abdulmajeed90/hopemesh-thesis/thesis/presentation.tex

\documentclass{beamer}
\usetheme{Madrid}

\usepackage[english]{babel}
\usepackage[utf8]{inputenc}

\usepackage{tikz}
\usetikzlibrary{mindmap,trees}

\usepackage{import}

\usepackage{listings}
\lstset{basicstyle=\footnotesize\ttfamily}

\title[Master thesis presentation]{Communication algorithms and principles for a prototype of a wireless mesh network}
\author[Sergiusz Urbaniak]{}
\institute[WIZUT]
{
    Zachodniopomorski Uniwersytet Technologiczny w Szczecinie \\
    Wydział Informatyki \\[2cm]
    Sergiusz Urbaniak
}

\date[Szczecin, 2011]{}

\begin{document}
\include{slides}
\end{document}
