abdulmajeed90/hopemesh-thesis/thesis/praca.tex

% comment/uncomment for oneside production (odd and even pages have same margins)
\input{class}
%\documentclass[12pt, oneside]{_praca_dyplomowa}

% comment/uncomment for twoside production (odd and even pages have reverse margins)
% \documentclass[12pt, twoside]{_praca_dyplomowa}

% rozmiar marginesów
\usepackage[a4paper, left=3.5cm, right=2cm, bottom=2.5cm, top=3cm]{geometry}
% zmieniony margines dla stron parzystych (druk dwustronny):
%\usepackage[a4paper, left=2cm, right=3.5cm, bottom=2.5cm, top=3cm]{geometry}
%\usepackage{times}
%\usepackage[default, none]{oxford}
%\usepackage{chicago}
% polskie znaki
\usepackage{setspace}
\usepackage{amsmath}
%\usepackage{graphs}

\usepackage[english]{babel}
%\usepackage[OT4]{polski}
\usepackage[T1]{fontenc}
%\usepackage[MeX]{polski}
\usepackage[utf8]{inputenc}
\usepackage[parfill]{parskip}

%\usepackage[pausing]{tracefnt}

% rysunki w formacie EPS
\usepackage[pdftex]{color,graphicx}
\usepackage{graphicx}
\usepackage{epsfig}
\graphicspath{{figures/}}
\usepackage[pausing]{tracefnt}
%\usepackage{indentfirst} % akapit w pierwszej linii
\usepackage{color}
\definecolor{listing}{rgb}{0.1,0.3,0.3}
\usepackage{hyperref}
\hypersetup{
	unicode=true,
	pdftitle={Praca dyplomowa},
	pdfauthor={Sergiusz Urbaniak},
	pdfsubject={},
	pdfborder={0 0 0},
	pdfstartview=FitB,
	pdflang=pl,
	pdfdisplaydoctitle=true,
	plainpages=false
}
\usepackage{rotating}
\usepackage{import}
\usepackage{algorithmic}
\usepackage{algorithm}

\usepackage{listings}
\lstset{basicstyle=\footnotesize\ttfamily}

\usepackage{pdfpages}
\usepackage{url}

\usepackage{tikz}
\usetikzlibrary{mindmap,trees}

\usepackage{wrapfig}
\usepackage{lscape}

% uncomment next line in order to show margins in produced PDF
% \usepackage{showframe}

%\fontsize{10}{12pt}
\providecommand{\abs}[1]{\lvert#1\rvert}

%INFORMACJA O PRACY
%==================
\tytul{Communication algorithms and principles for a prototype of a wireless mesh network}
\engtitle{Communication algorithms and principles for a prototype of a wireless mesh network}
\autor{Sergiusz Urbaniak}
\opiekun{dr inż. Remigiusz Olejnik}
\rok{2011}
\slowa{rf12b, rfm12b, hoperf, avr, atmega16, topologia kratowa, sieæ}
\opis{Description}
\kwords{}
\describe{Description}
\sloppy

\begin{document}

%\renewcommand\tablename{Tabela}
%\renewcommand\figurename{Rys.}

\include{strona_tytulowa}
\setstretch{1.6}
\include{oswiadczenie}
\include{abstract}
\tableofcontents
\listoffigures
%\renewcommand\listtablename{Spis tabel} 
\listoftables
\include{content}

\begin{appendix}
\appendix
\include{appendix_a}
\end{appendix}

\addcontentsline{toc}{chapter}{Bibliography}
%\bibliographystyle{plain}
%\bibliographystyle{abbrv}
\bibliographystyle{is-unsrt}
\bibliography{bibliography}

\end{document}
