abdulmajeed90/hopemesh-thesis/thesis/oswiadczenie.tex

\setcounter{page}{1}
\chapter*{}

\vspace{1 cm}
\begin{center}                        
\LARGE{ \bf{Oświadczenie}} \\
\end{center}
Oświadczam, że przedkładaną pracę magisterską kończącą studia napisałem samodzielnie. Oznacza to, że przy pisaniu pracy poza niezbędnymi konsultacjami, nie korzystałem z pomocy innych osób, a w szczególności nie zlecałem opracowania rozprawy lub jej części innym osobom, ani nie odpisywałem rozprawy lub jej części od innych osób.
Potwierdzam też zgodność wersji papierowej i elektronicznej złożonej pracy. Mam świadomość, że poświadczenie nieprawdy będzie w tym przypadku skutkowało cofnięciem decyzji o wydaniu dyplomu.
\vspace{3.0cm}
\begin{flushleft}
\hspace{10.0 cm}     Sergiusz Urbaniak\\
\end{flushleft}

\normalsize
