abdulmajeed90/hopemesh-thesis/thesis/strona_tytulowa.tex

\begin{titlepage}
 \centering
  \vfill{\Large \sc
     Zachodniopomorski Uniwersytet Technologiczny \\
     w Szczecinie
   } \\

   \vspace{0.5cm}
   \Large \textbf{WYDZIAŁ INFORMATYKI} \\

   \vspace{2cm}
   \epsfig{file={logowi.png},width=2.21cm} \\ 

   \vspace{3.0 cm}
   \Large \Autor \\

   \vspace{0.3 cm}
   \normalsize Kierunek informatyka \\

   \vspace{1 cm}
   \LARGE \textbf{\Tytul} \\ 

\begin{flushleft}
  \vspace{2.7 cm}{\normalsize
     \hspace{7.0 cm} Praca dyplomowa magisterska\\
     \hspace{7.0 cm} napisana pod kierunkiem \\
     \hspace{7.0 cm} \textbf{dr inż. Remigiusza Olejnika} \\
     \hspace{7.0 cm} w Katedrze Architektury Komputerów \\
     \hspace{7.0 cm} i Telekomunikacji \\
  }
\end{flushleft}

   \vspace{1.5 cm}
       {\large \Rok}
   \vfill                         
\end{titlepage}
