abdulmajeed90/hopemesh-thesis/thesis/appendix_a.tex

\chapter{CD Content}
\label{cha:appendix_a}

The following complementary thesis binary content is available on the attached CD:

\begin{itemize}
    \item \textbf{/pcb} --- KiCad source files for the printed circuit board
        \begin{itemize}
            \item \textbf{hopemesh-sch.ps} --- The schematic as PostScript
            \item \textbf{hopemesh-sch-Level Shifter.ps} --- The level shifter schematic as PostScript
        \end{itemize}
    \item \textbf{/src} --- The source files for the hopemesh implementation
    \item \textbf{/petri} --- The petri net binary and simulation file
        \begin{itemize}
            \item \textbf{threads.pnt} The petri net simulation file
            \item \textbf{petri.jar} The java petri net executable. Start with "java -jar petri.jar".
        \end{itemize}
    \item \textbf{/thesis} --- The latex source files of this thesis
        \begin{itemize}
            \item \textbf{praca.pdf} The thesis in the PDF format
        \end{itemize}
\end{itemize}

The current hopemesh distribution is also available at \url{https://github.com/mieszkoman/hopemesh} released as open source.
