abdulmajeed90/hopemesh-thesis/thesis/presentation.pdf

# Communication algorithms and principles for a prototype of a wireless mesh network

### Zachodniopomorski Uniwersytet Technologiczny w Szczecinie Wydzia l Informatyki

### Sergiusz Urbaniak

Sergiusz Urbaniak (WIZUT) | Master thesis presentation | Szczecin, 2011 | 1 / 6

# Outline

1 | Introduction
2 | Research Overview
3 | Architecture
Sergiusz Urbaniak (WIZUT) | Master thesis presentation | Szczecin, 2011 | 2 / 6

# Project mind map

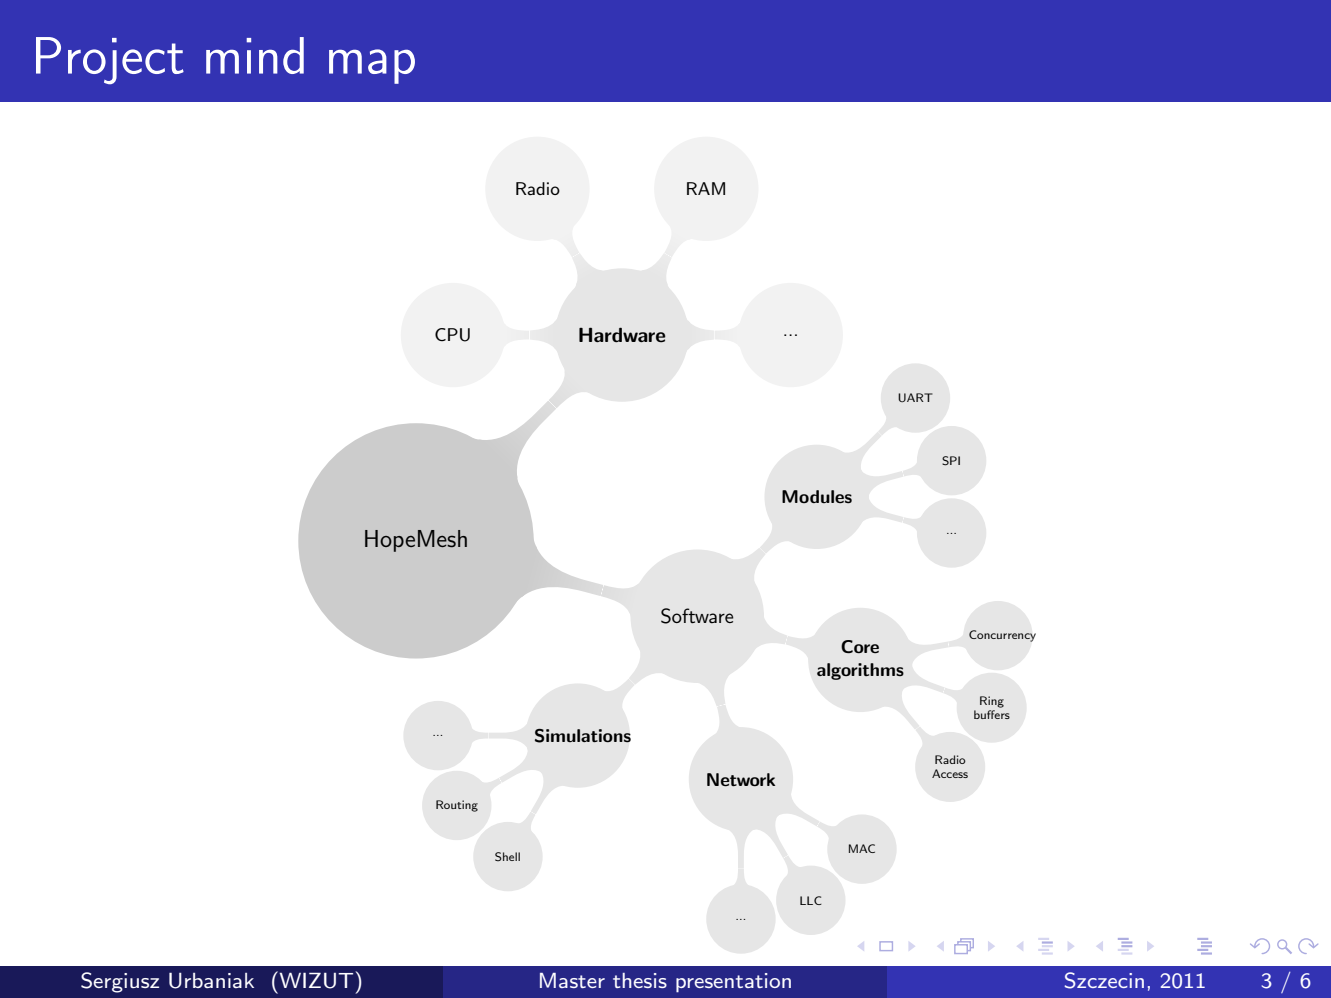
[picture p4: page 3]
HopeMesh; CPU; Hardware; Radio; RAM; Software; Modules; UART; SPI; Core algorithms; Concurrency; Ring buffers; Radio Access Network; MAC; LLC; Simulations; Shell; Routing; Sergiusz Urbaniak (WIZUT); Master thesis presentation; Szczecin, 2011

# Module Architecture

## UART

Watchdog | Timer | SPI
Shell | Receiver

## Clock

Network | RFM12

## driver

driver | driver
userspace | userspace
library | driver

## daemon

## daemon

Sergiusz Urbaniak (WIZUT) | Master thesis presentation | Szczecin, 2011 | 4 / 6

# Concurrency Model

# Sequential Execution

# Concurrent Execution

Sergiusz Urbaniak (WIZUT) | Master thesis presentation | Szczecin, 2011 | 5 / 6

# Petri net driver

## rfm12 lock

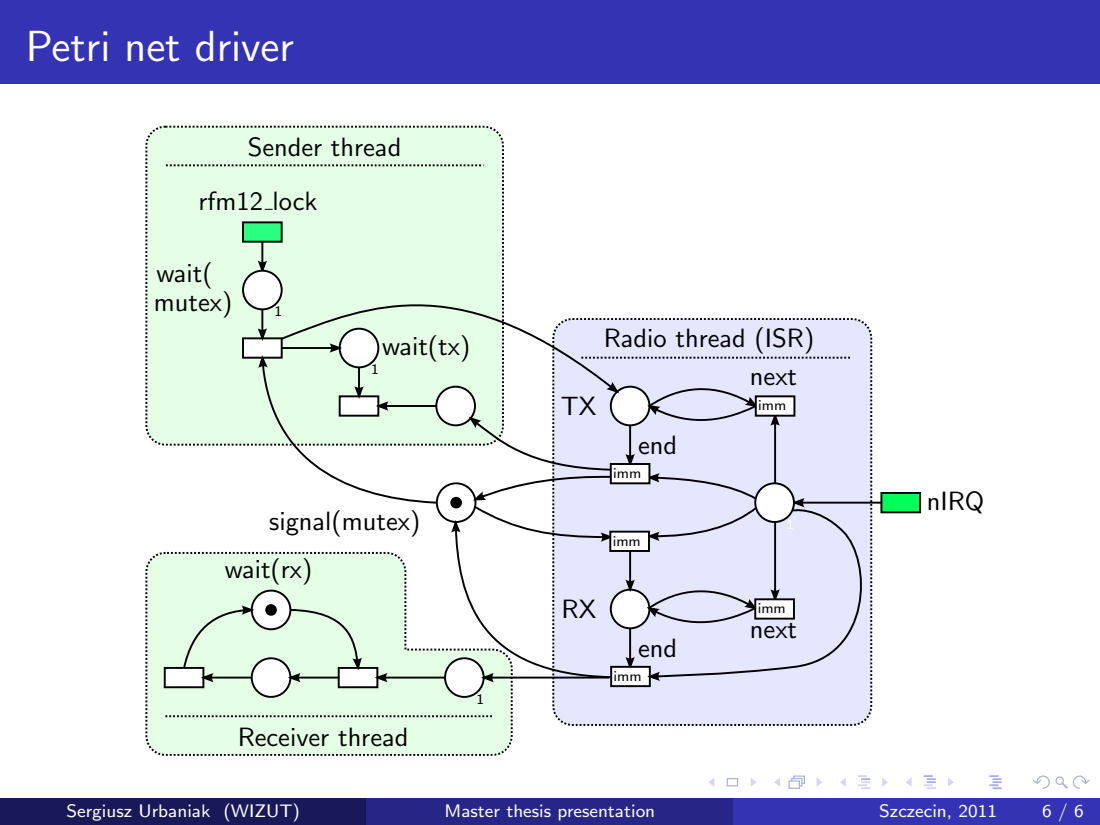
[picture p5: page 6]
nIRQ; next; end; imm; signal(mutex); wait(; mutex); wait(tx); wait(rx); Sender thread; Receiver thread; Sergiusz Urbaniak (WIZUT); Master thesis presentation; Szczecin, 2011

Radio thread (ISR)
