abdulmajeed90/hopemesh-thesis/thesis/mindmap.tex

\path[mindmap, concept color=lightgray!80]
node[concept] {HopeMesh}
[clockwise from=45]
child[concept color=lightgray!70] {node[concept] {\textbf{Hardware}}
    [clockwise from=180]
    child[concept color=lightgray!60] {node[concept] {CPU}}
    child[concept color=lightgray!60] {node[concept] {Radio}}
    child[concept color=lightgray!60] {node[concept] {RAM}}
    child[concept color=lightgray!60] {node[concept] {...}}
}
child[concept color=lightgray!70] {node[concept] {Software}
    child {node[concept] {\textbf{Modules}}
        child {node[concept] {UART}}
        child {node[concept] {SPI}}
        child {node[concept] {...}}
    }
    child {node[concept] {\textbf{Core algorithms}}
        [clockwise from=10]
        child {node[concept] {Concurrency}}
        child {node[concept] {Ring buffers}}
        child {node[concept] {Radio Access}}
    }
    child {node[concept] {\textbf{Network}}
        [clockwise from=330]
        child {node[concept] {MAC}}
        child {node[concept] {LLC}}
        child {node[concept] {...}}
    }
    child {node[concept] {\textbf{Simulations}}
        [clockwise from=240]
        child {node[concept] {Shell}}
        child {node[concept] {Routing}}
        child {node[concept] {...}}
    }
}
;
