abdulmajeed90/hopemesh-thesis/thesis/figures/client_wmn.pdf

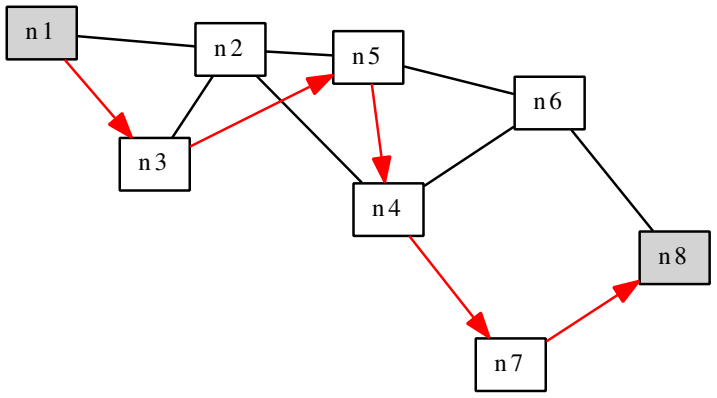
[picture p6: figure]
