abdulmajeed90/hopemesh-thesis/thesis/figures/concurrent_execution.pdf

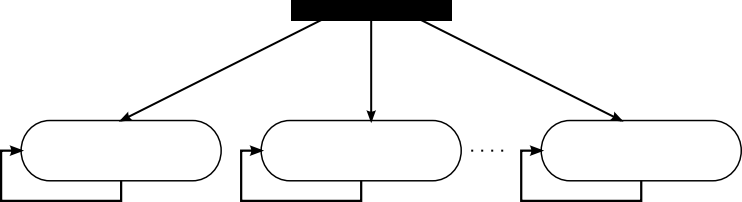
[picture p7: figure]
