abdulmajeed90/hopemesh-thesis/thesis/figures/sequential_execution.pdf

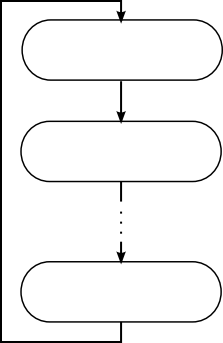
[picture p8: figure]
