abdulmajeed90/hopemesh-thesis/thesis/figures/mutex.pdf

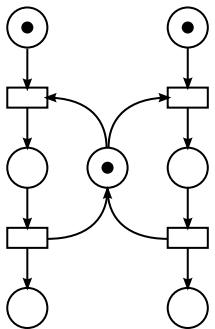
[picture p9: figure]
