abdulmajeed90/hopemesh-thesis/thesis/figures/ringbuffer.pdf

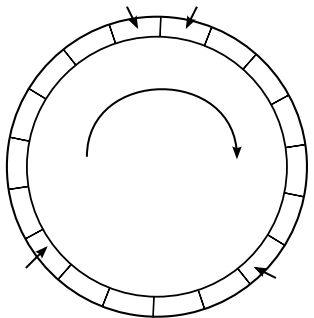
[picture p10: figure]
