abdulmajeed90/hopemesh-thesis/thesis/figures/state_machine.pdf

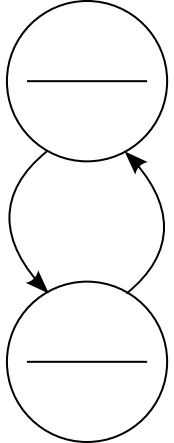
[picture p11: figure]
