abdulmajeed90/hopemesh-thesis/thesis/figures/2nd_rev_pcb.jpg

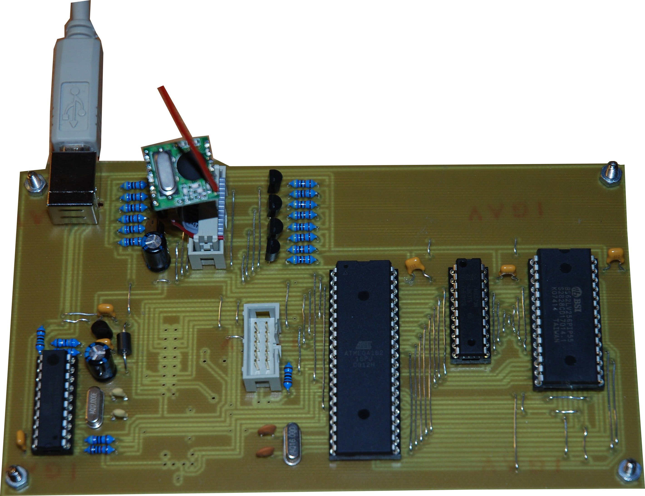
thesis/figures/2nd_rev_pcb.jpg
