abdulmajeed90/hopemesh-thesis/thesis/figures/prototype_pcb.jpg

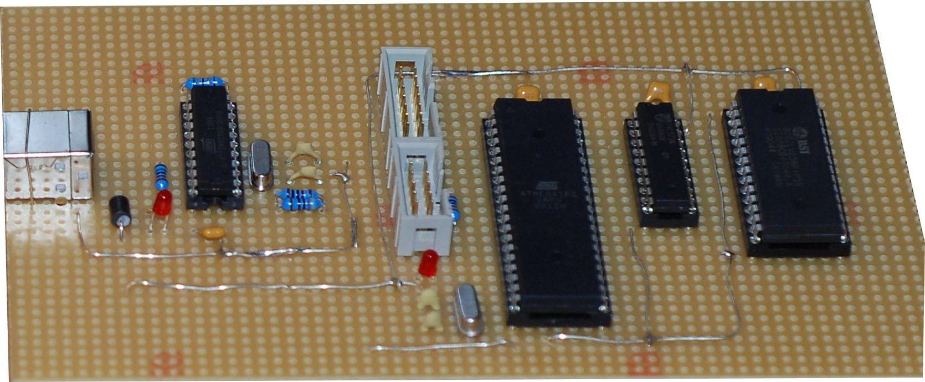
thesis/figures/prototype_pcb.jpg
