abdulmajeed90/hopemesh-thesis/thesis/figures/modules_component_diagram.pdf

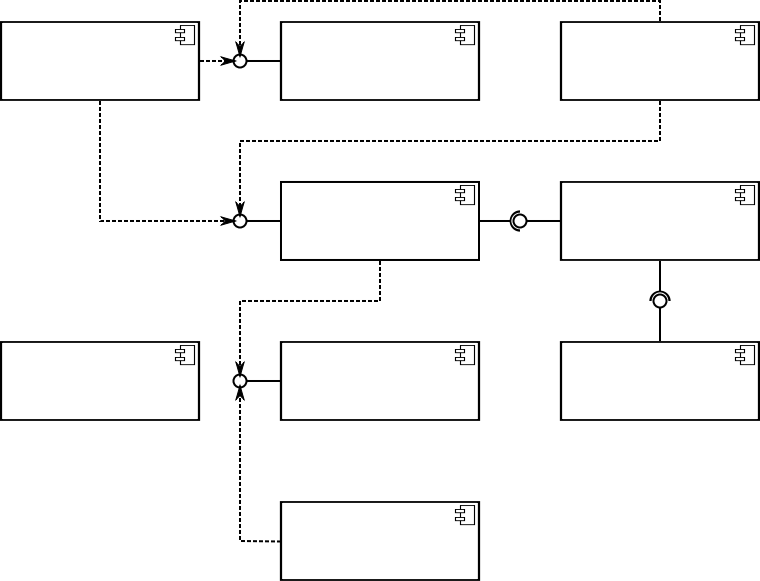
[picture p14: figure]
