abdulmajeed90/hopemesh-thesis/thesis/figures/test0.pdf

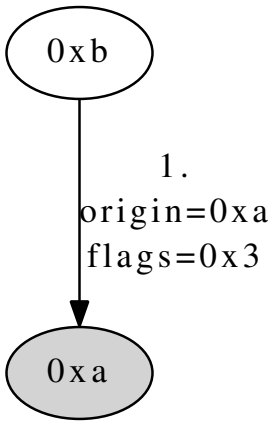
[picture p15: figure]
1. origin=0xa flags=0x3
