abdulmajeed90/hopemesh-thesis/thesis/figures/test1.pdf

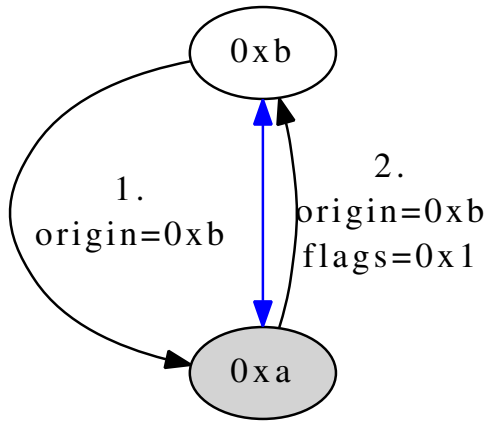
[picture p16: figure]
1. origin=0xb; 2. origin=0xb flags=0x1
