abdulmajeed90/hopemesh-thesis/thesis/figures/test2.pdf

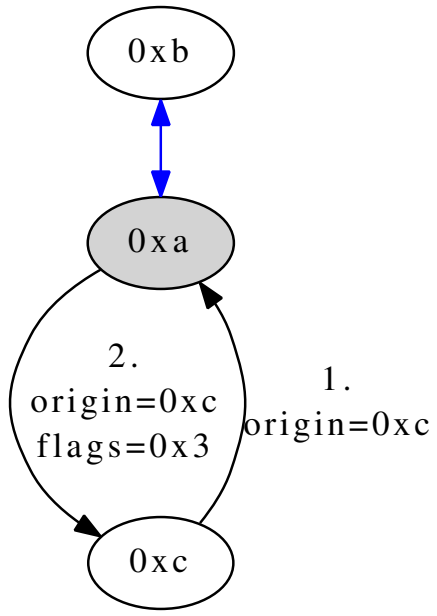
[picture p17: figure]
2. origin=0xc flags=0x3; 1. origin=0xc
