abdulmajeed90/hopemesh-thesis/thesis/figures/test3.pdf

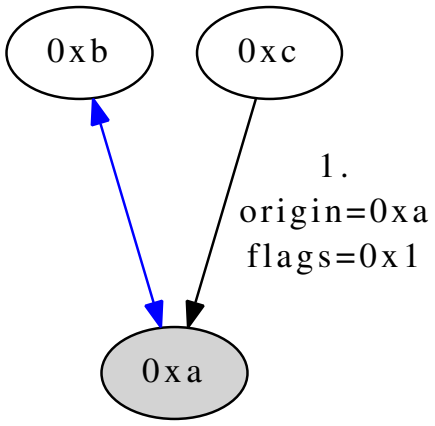
[picture p18: figure]
1. origin=0xa flags=0x1
