abdulmajeed90/hopemesh-thesis/thesis/figures/test6.pdf

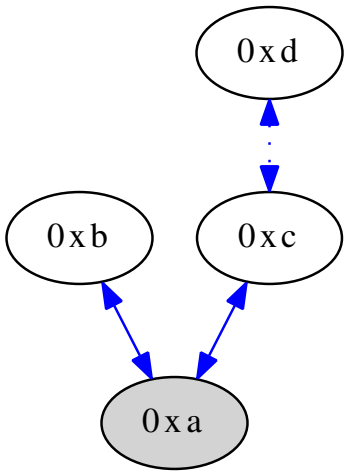
[picture p19: figure]
