abdulmajeed90/hopemesh-thesis/thesis/figures/test9.pdf

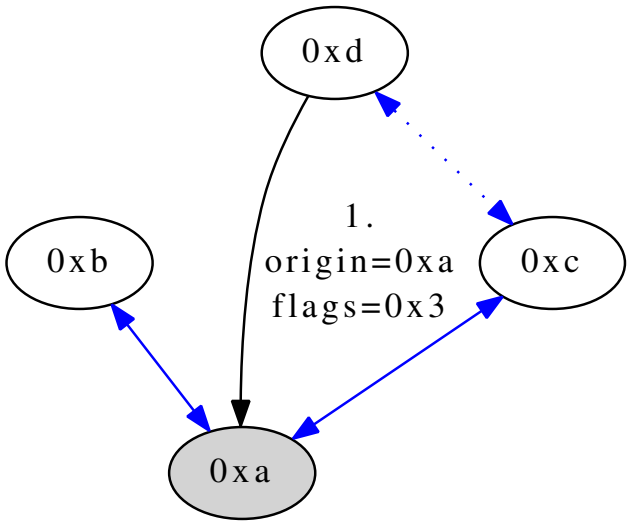
[picture p20: figure]
1. origin=0xa flags=0x3
