abdulmajeed90/hopemesh-thesis/thesis/figures/testfinal.pdf

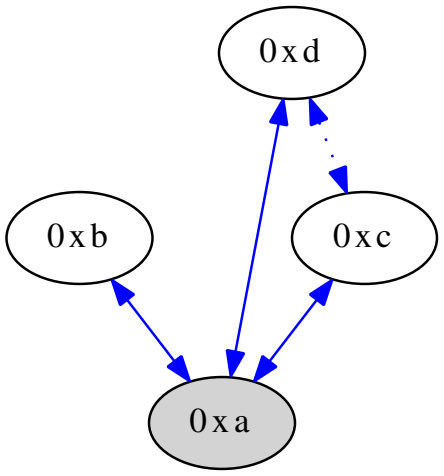
[picture p21: figure]
