abdulmajeed90/hopemesh-thesis/thesis/figures/hopemesh-sch-crop.pdf

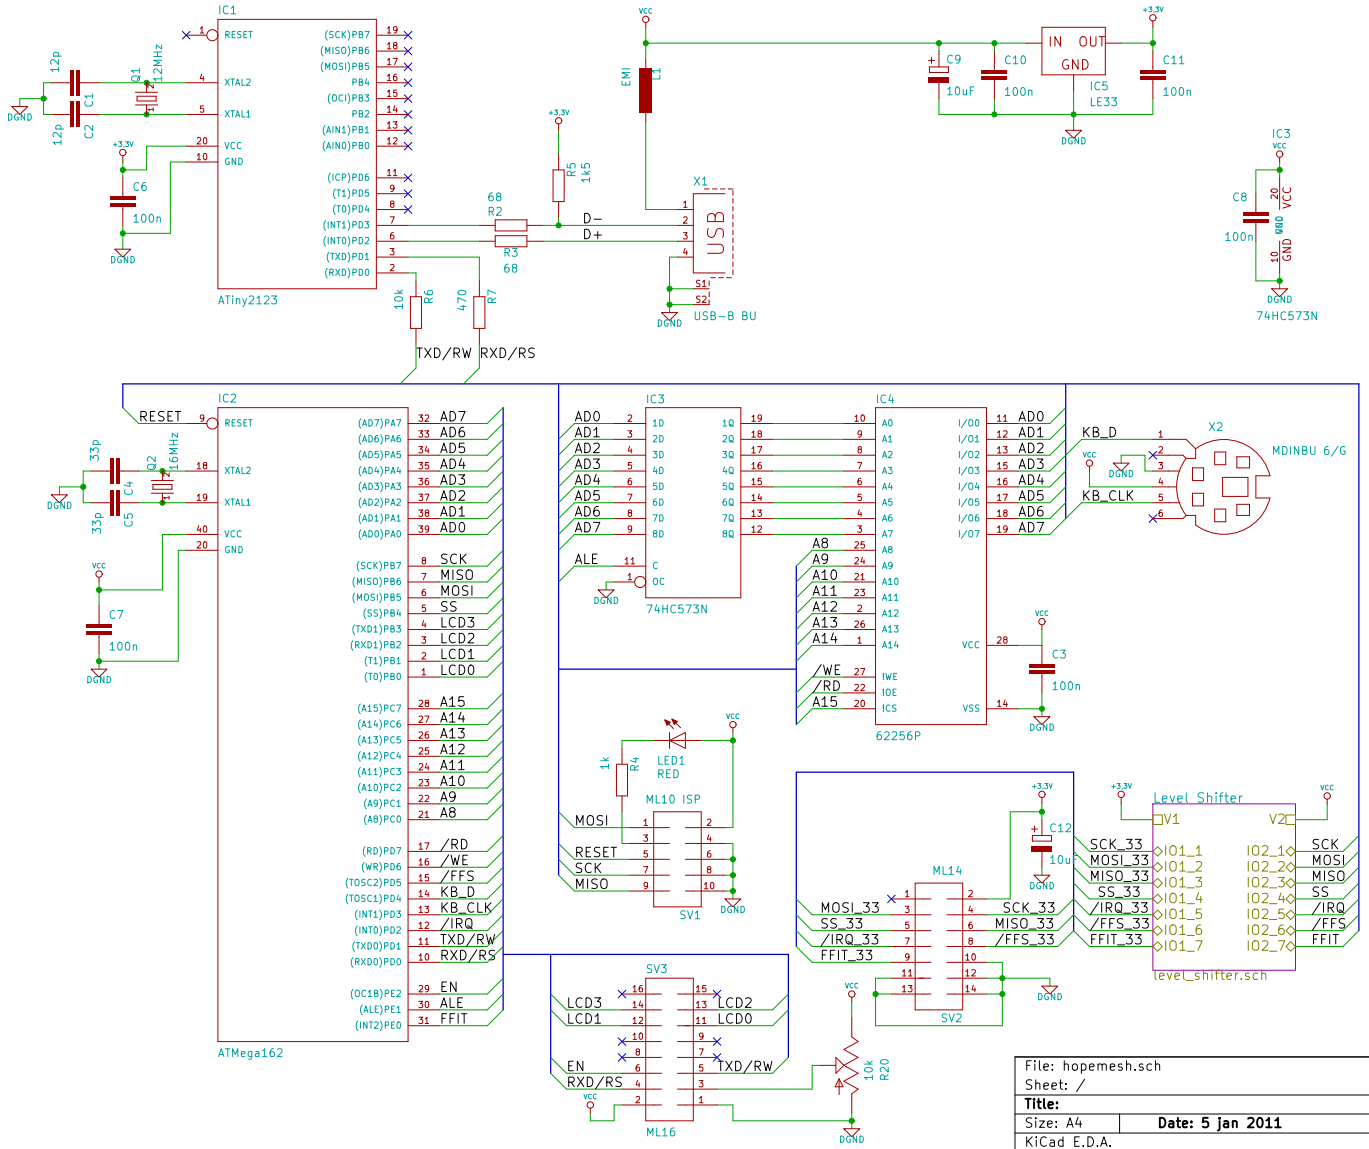
[picture p22: page 1]
