abdulmajeed90/hopemesh-thesis/thesis/figures/hopemesh-sch-levelshifter-crop.pdf

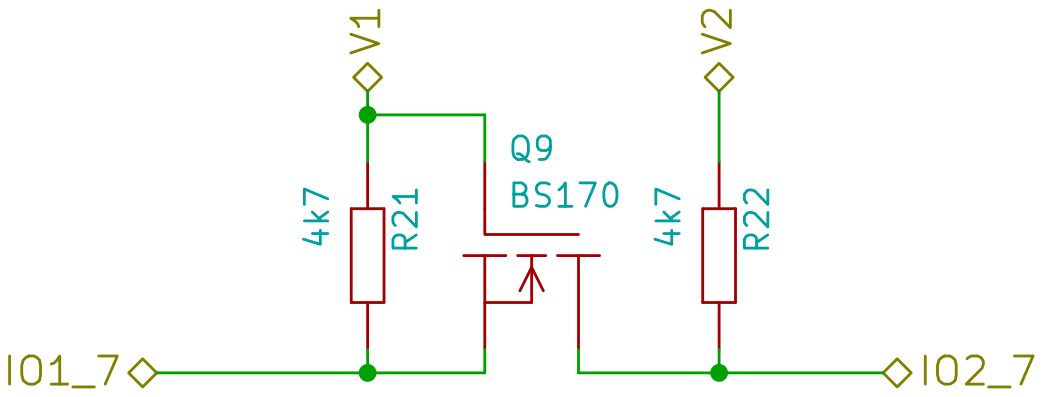
[picture p23: page 1]
