abdulmajeed90/hopemesh-thesis/thesis/figures/ogm_rx_activity_diagram.pdf

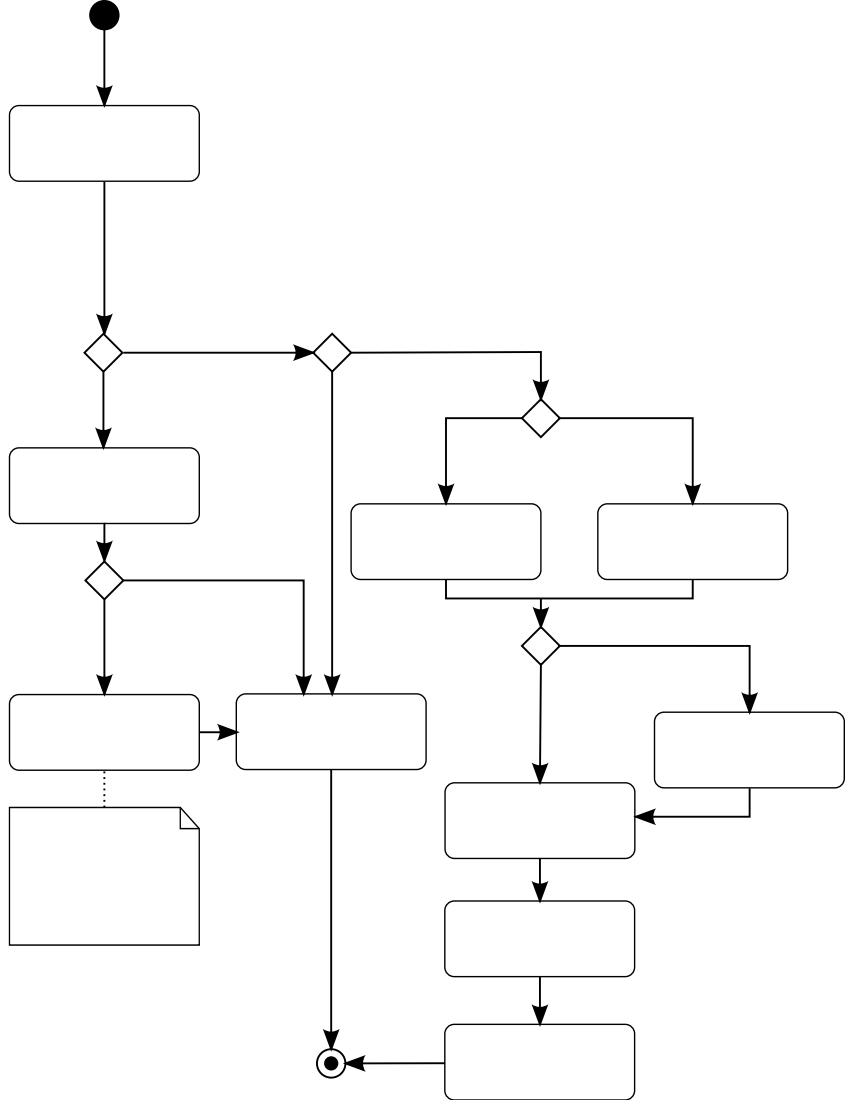
[picture p24: page 1]
