abdulmajeed90/hopemesh-thesis/thesis/figures/test10.pdf

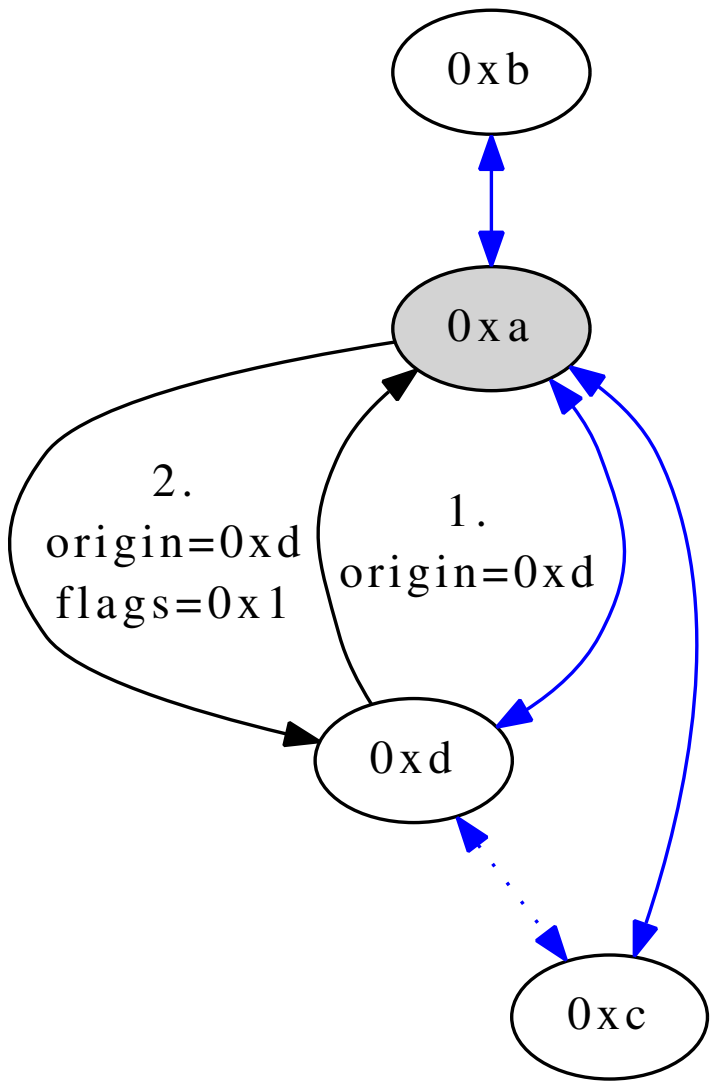
[picture p25: page 1]
2. origin=0xd flags=0x1; 1. origin=0xd
