abdulmajeed90/hopemesh-thesis/thesis/figures/test11.pdf

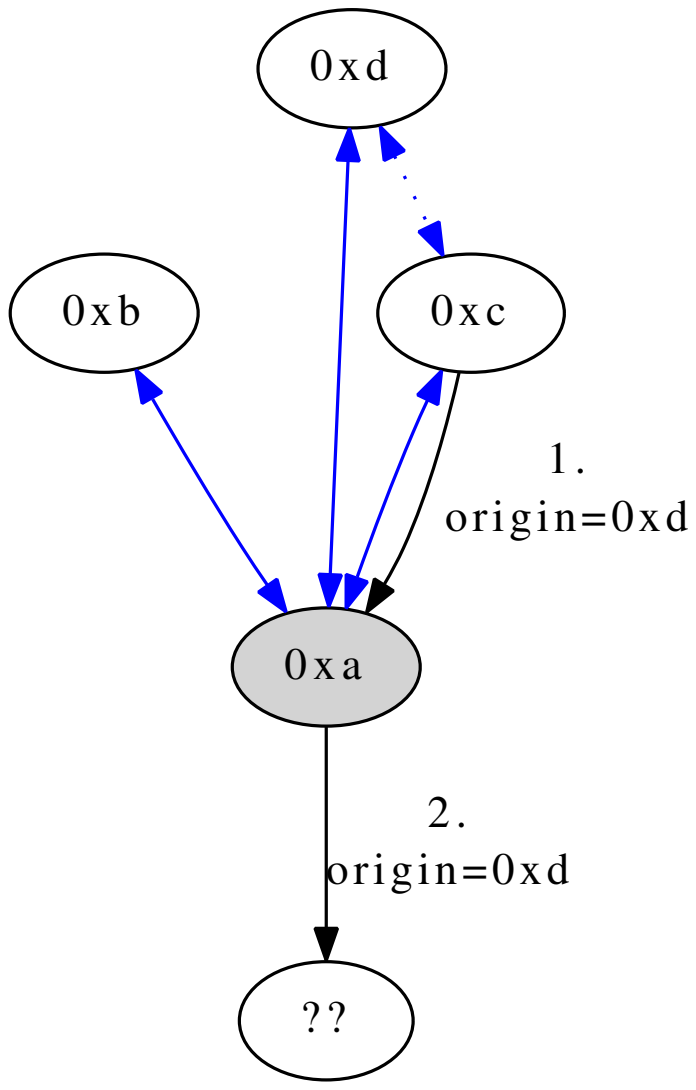
[picture p26: page 1]
2. origin=0xd; 1. origin=0xd
