abdulmajeed90/hopemesh-thesis/thesis/figures/test4.pdf

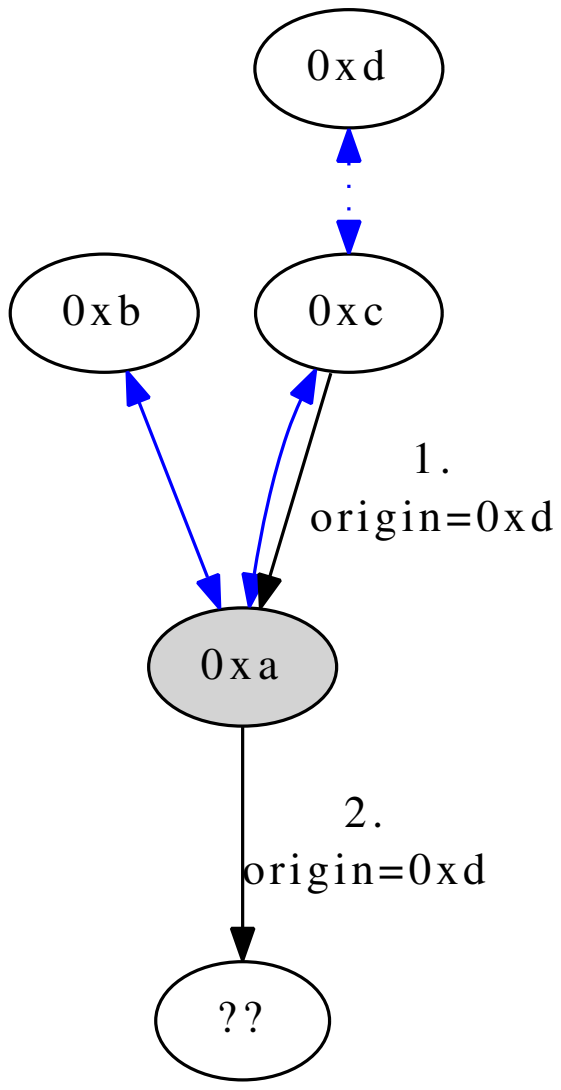
[picture p27: page 1]
2. origin=0xd; 1. origin=0xd
