abdulmajeed90/hopemesh-thesis/thesis/figures/test5.pdf

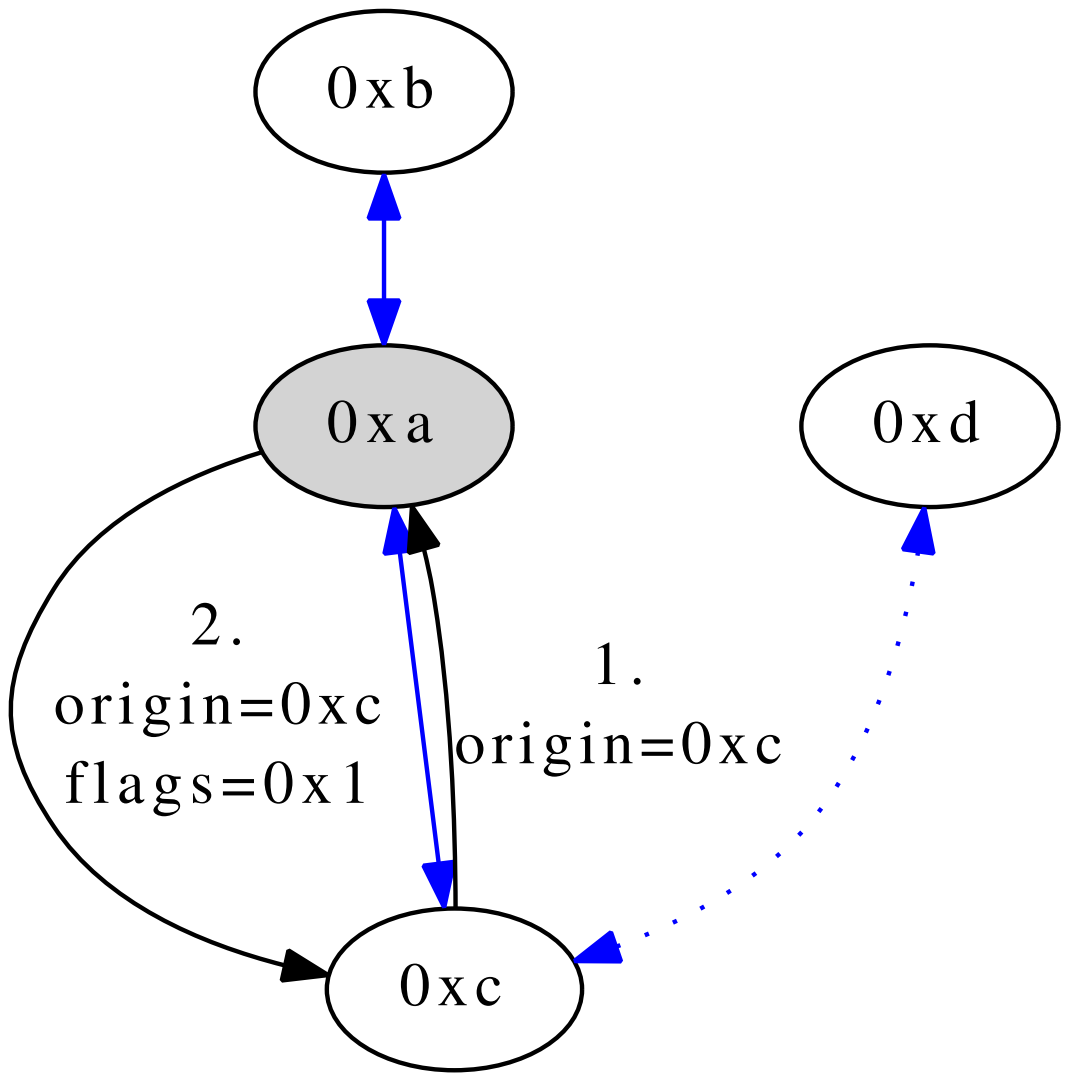
[picture p28: page 1]
2. origin=0xc flags=0x1; 1. origin=0xc
