abdulmajeed90/hopemesh-thesis/thesis/figures/rfm12_petri_rx3.pdf

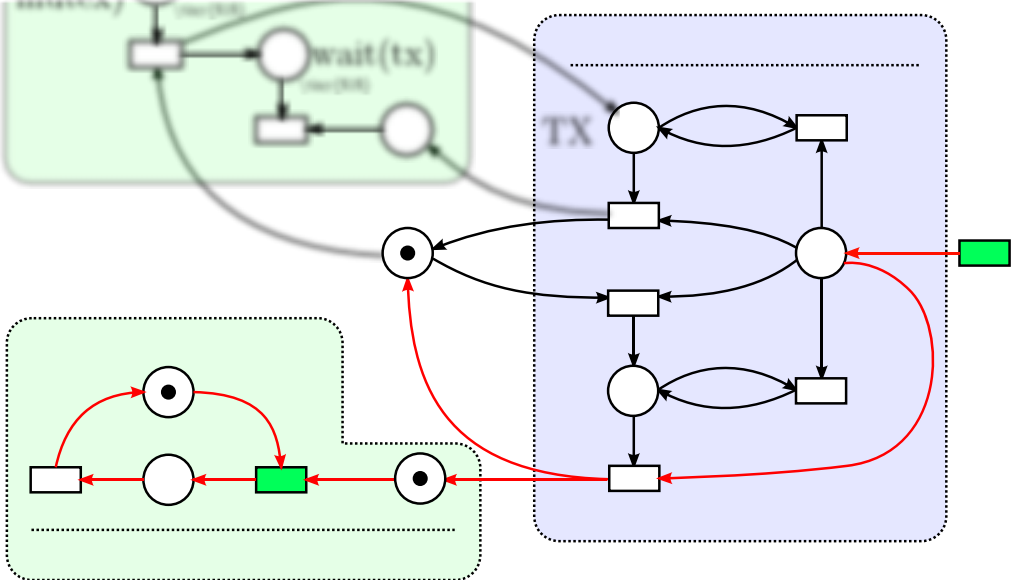
[picture p29: page 1]
