abdulmajeed90/hopemesh-thesis/thesis/figures/rfm12_petri_tx1.pdf

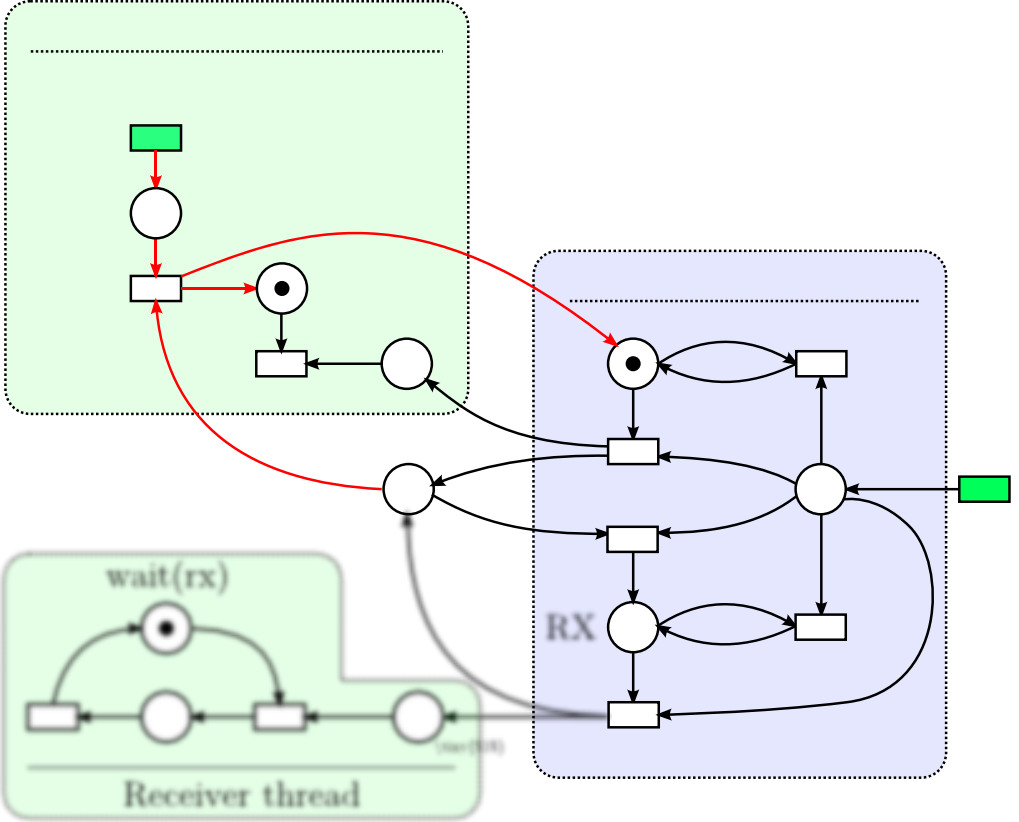
[picture p30: page 1]
