abdulmajeed90/hopemesh-thesis/thesis/figures/rfm12_petri_tx2.pdf

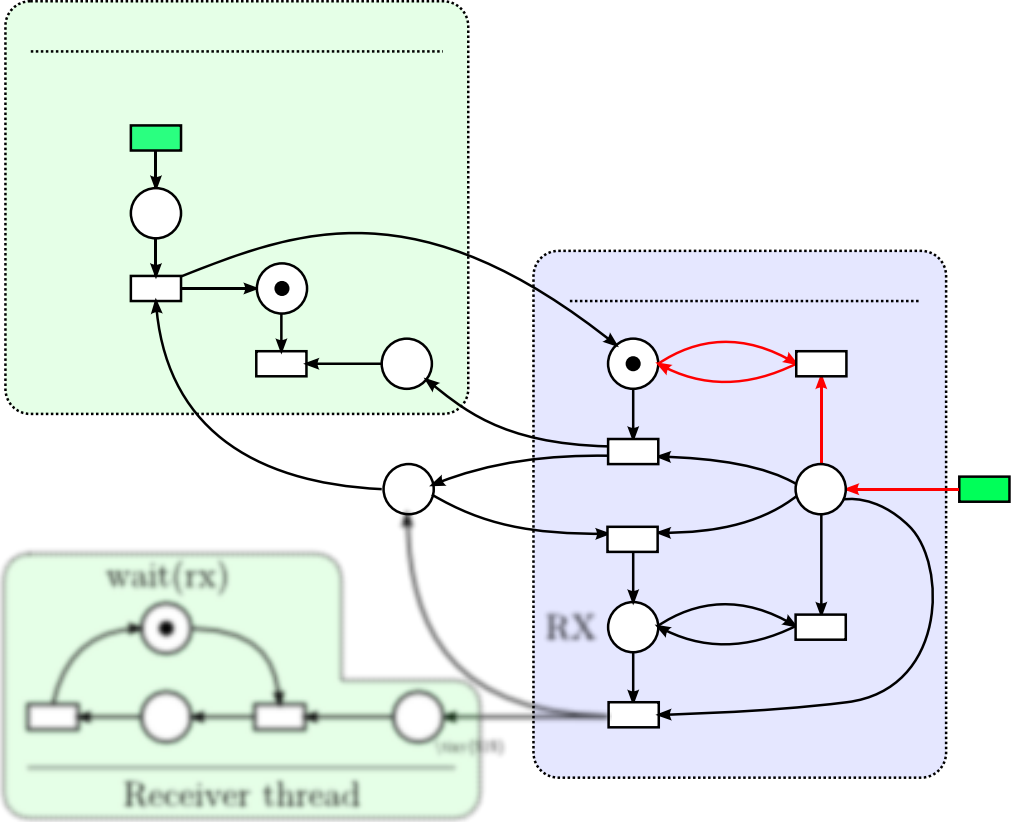
[picture p31: page 1]
