abdulmajeed90/hopemesh-thesis/thesis/figures/rfm12_petri_tx3.pdf

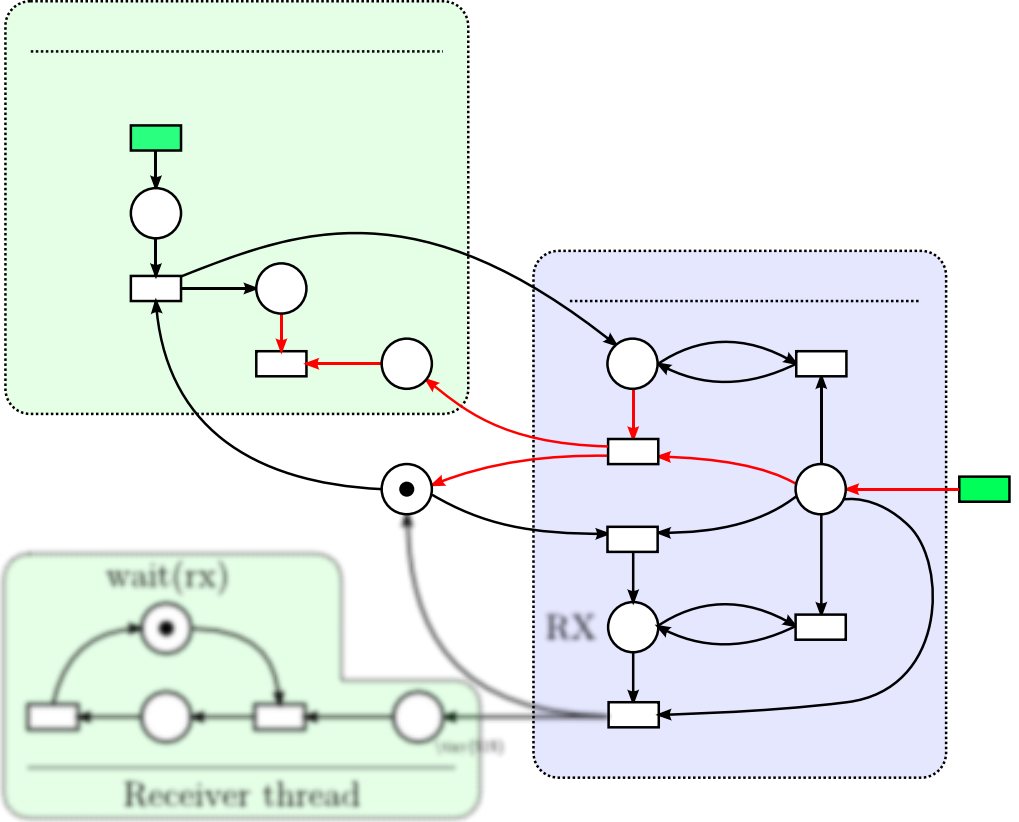
[picture p32: page 1]
