abdulmajeed90/hopemesh-thesis/thesis/figures/rfm12_petri.pdf

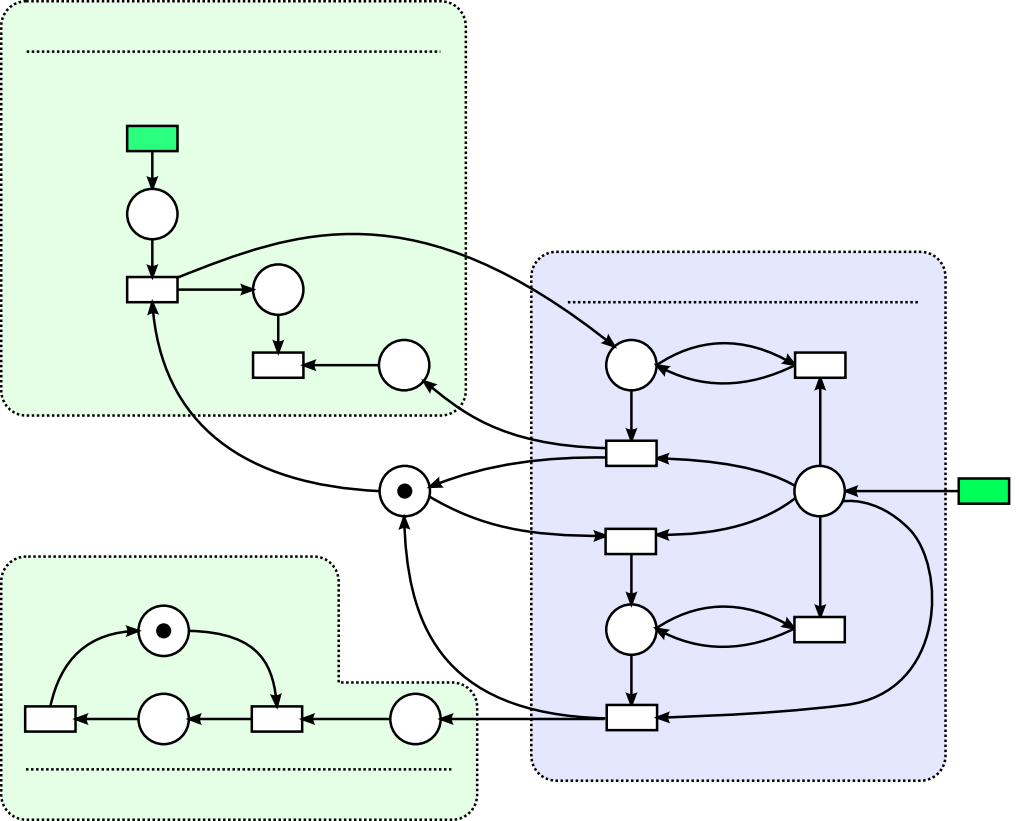
[picture p33: page 1]
