abdulmajeed90/hopemesh-thesis/thesis/figures/rfm12_petri_rx1.pdf

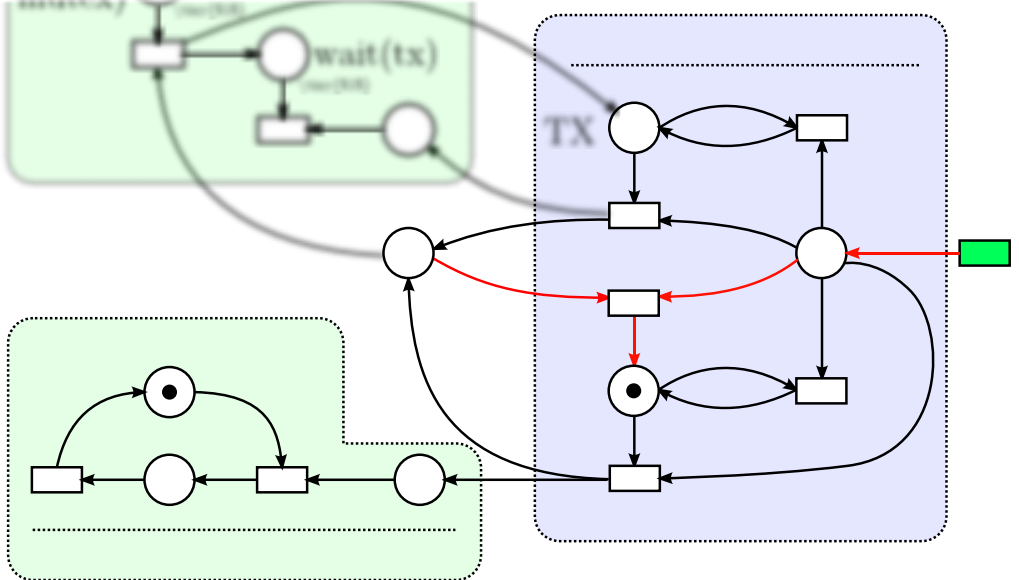
[picture p34: page 1]
