abdulmajeed90/hopemesh-thesis/thesis/figures/rfm12_petri_rx2.pdf

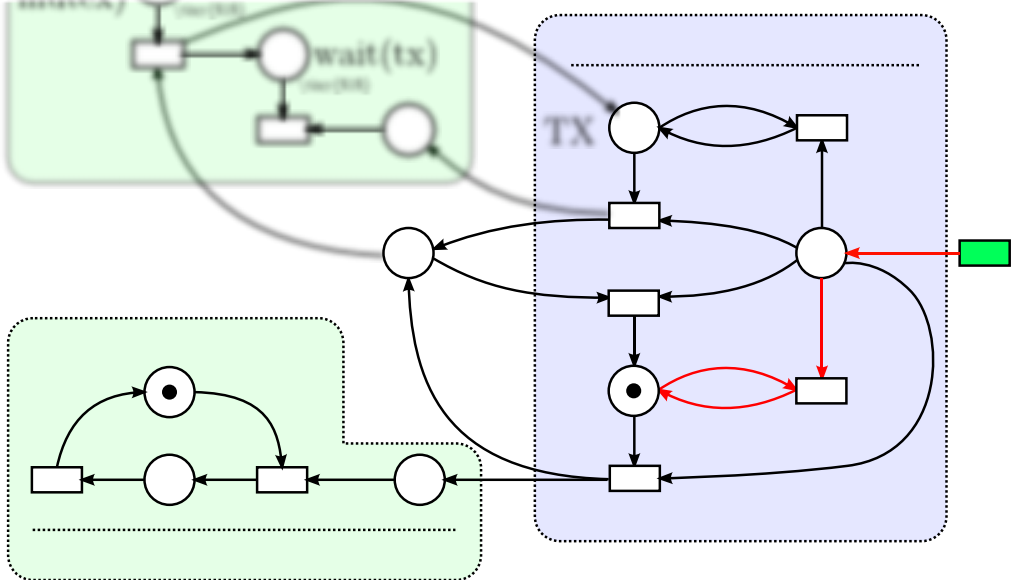
[picture p35: page 1]
