abdulmajeed90/hopemesh-thesis/thesis/figures/unicast_rx_activity_diagram.pdf

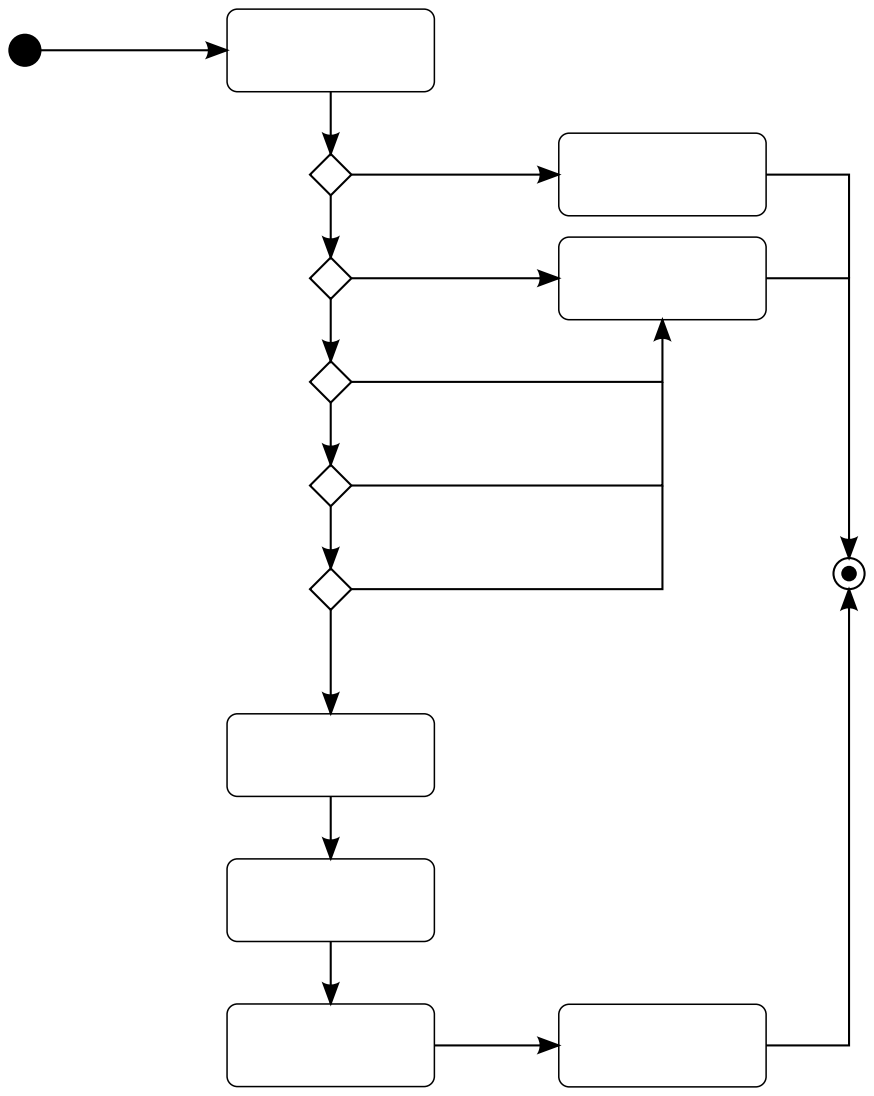
[picture p36: page 1]
