abdulmajeed90/hopemesh-thesis/thesis/figures/hopemesh-sch-levelshifter.pdf

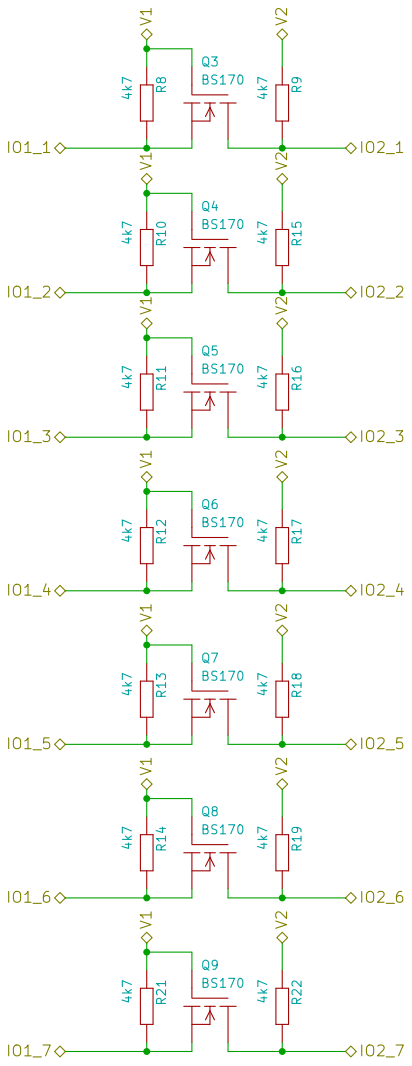
[picture p37: page 1]
