abdulmajeed90/hopemesh-thesis/thesis/figures/hopemesh-sch.pdf

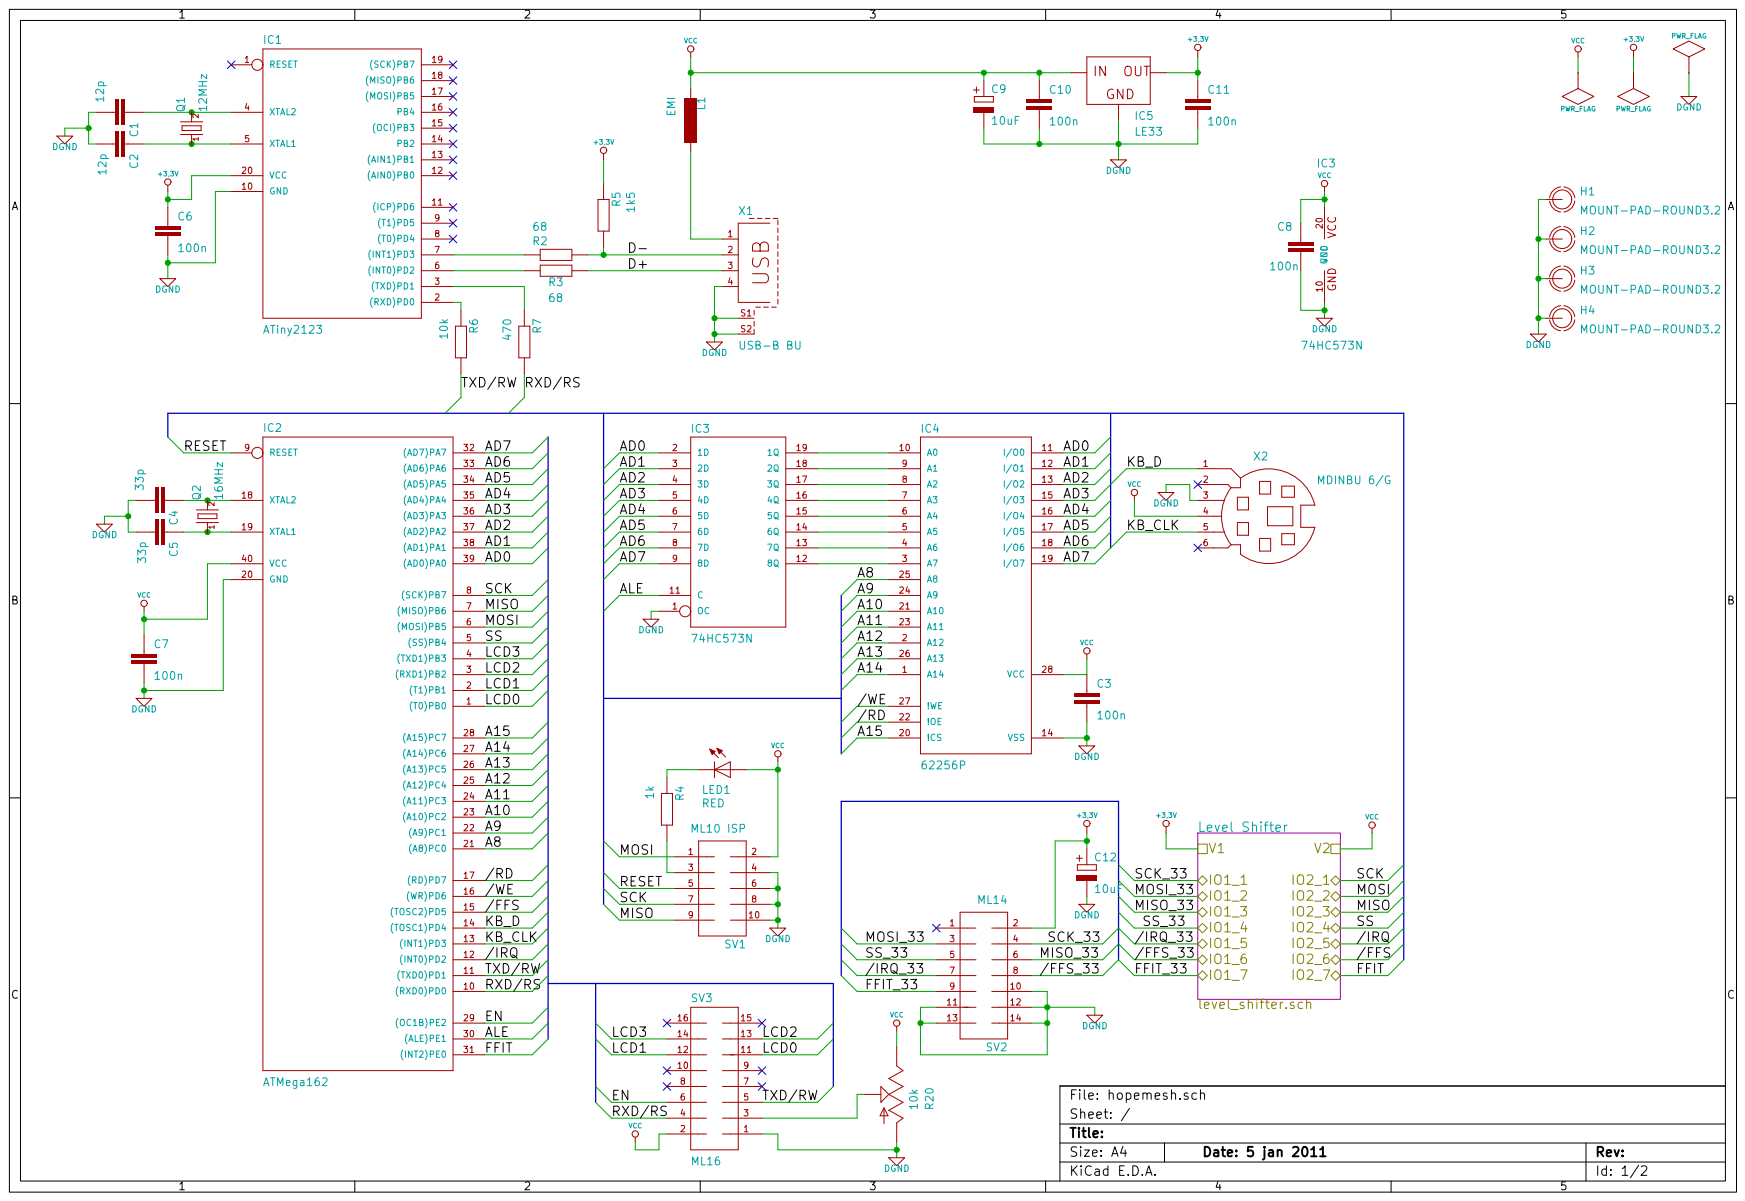
[picture p38: page 1]
