abdulmajeed90/hopemesh-thesis/pcb/hopemesh.sch

## KiCad design pcb/hopemesh.sch (2011-03-14)

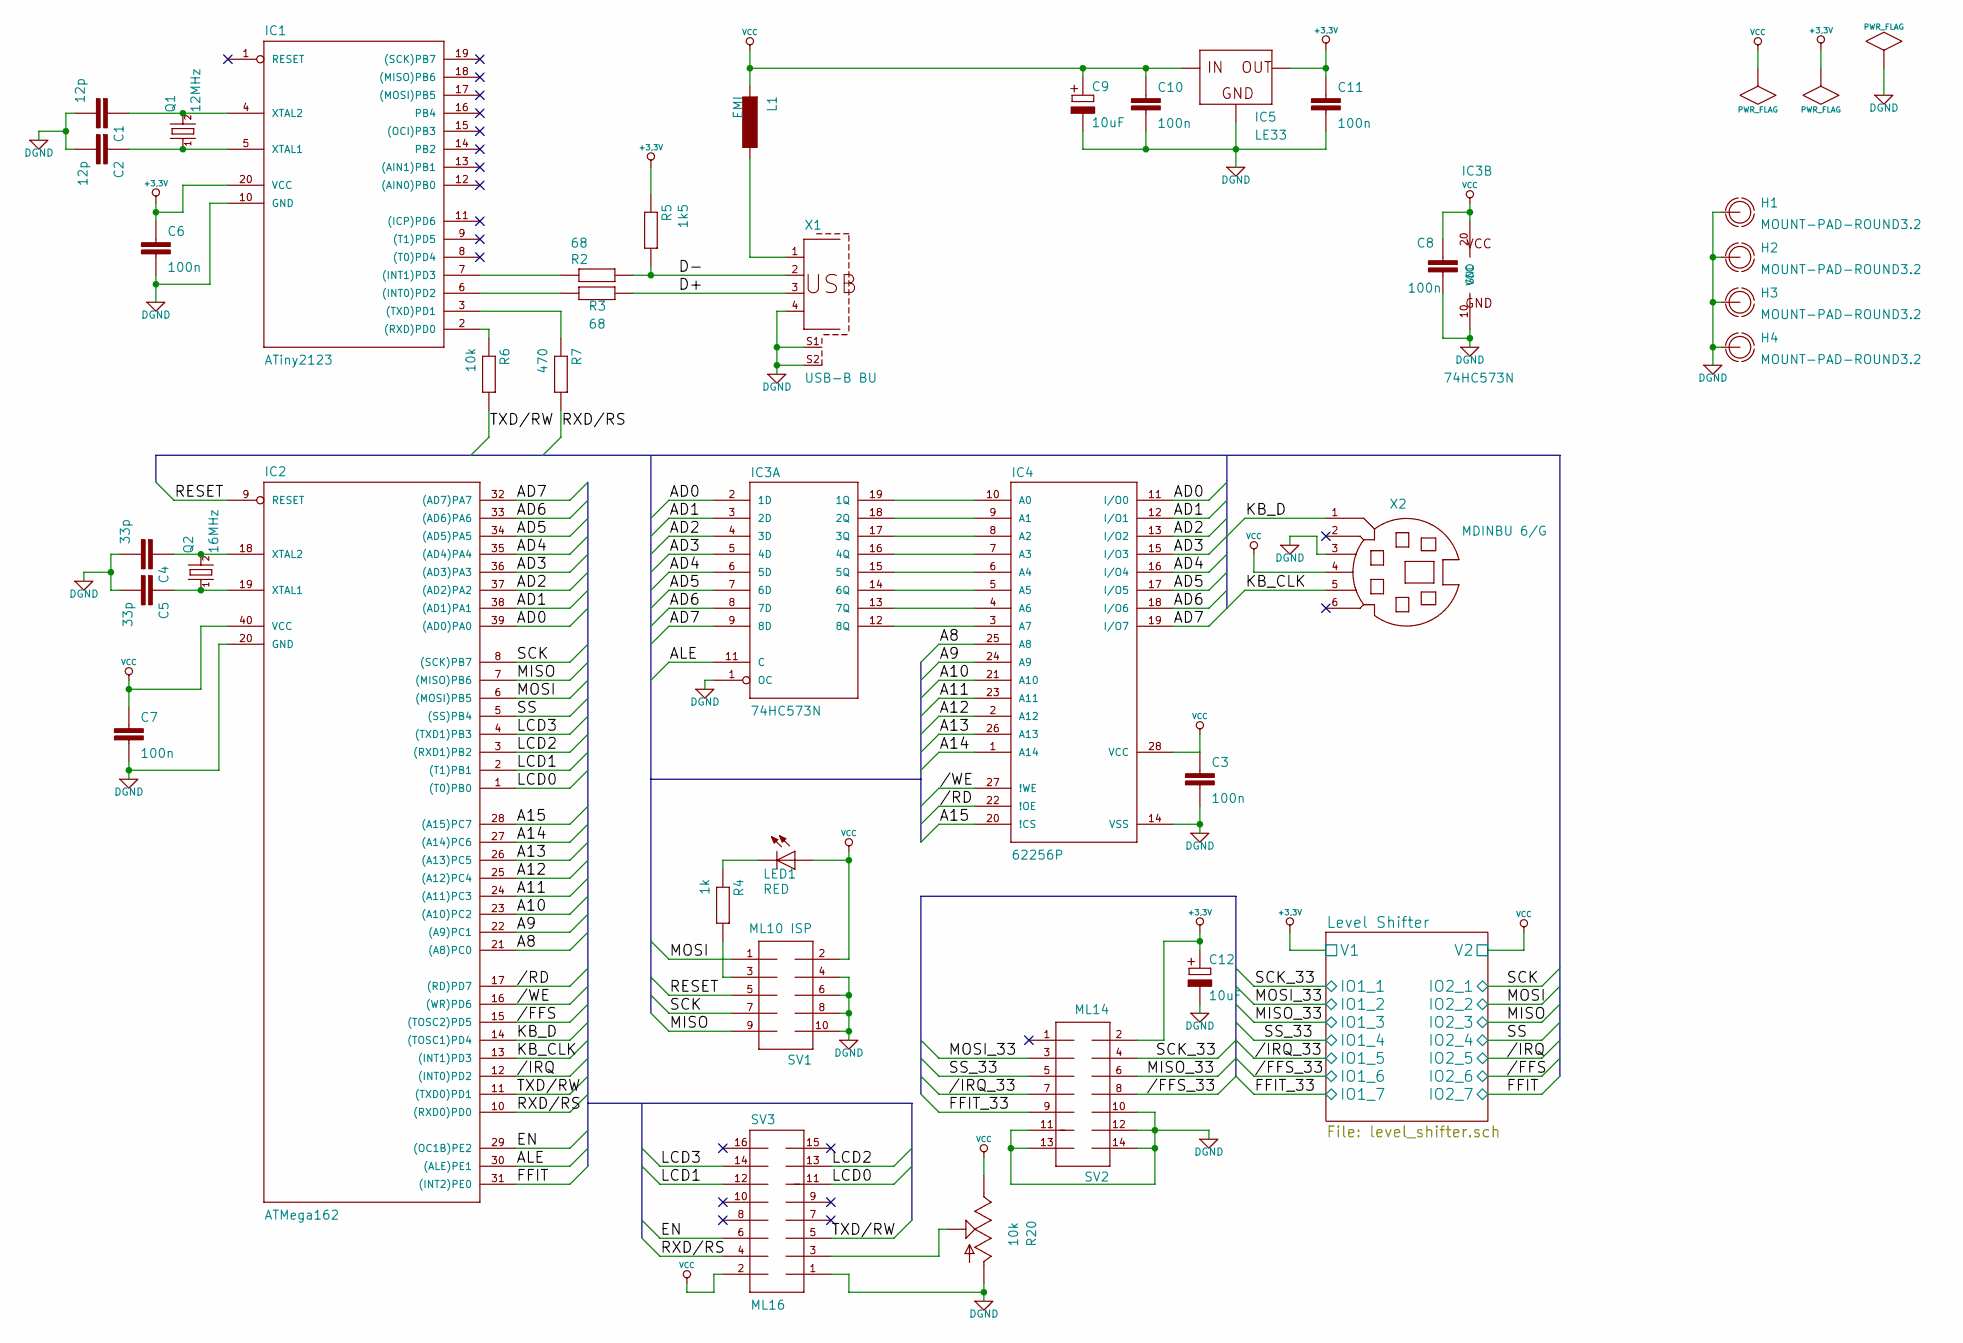
[picture p39: schematic hopemesh.sch]

Parts:
C1, C2: 12p; rcl-C025-040X050
C3, C7: 100n
C4, C5: 33p; rcl-C025-040X050
C6, C8, C10, C11: 100n; rcl-C050-024X044
C9: 10uF; rcl-085CS_1AR
C12: 10uF; rcl-E2,5-7
H1, H2, H3, H4: MOUNT-PAD-ROUND3.2; holes-3,2-PAD
IC1: ATiny2123; atmel-DIL20
IC2: ATMega162; atmel-DIL40
IC3: 74HC573N; 74xx-eu-DIL20
IC4: 62256P; memory-hitachi-DIL28-6
IC5: LE33; v-reg-TO92
L1: EMI; rcl-IR-4
LED1: RED; led-LED3MM
Q1: 12MHz
Q2: 16MHz; crystal-HC49U70
R2, R3: 68; rcl-0204/7
R4: 1k; rcl-0204/7
R5: 1k5; rcl-0204/7
R6: 10k; rcl-0204/7
R7: 470; rcl-0204/7
R20: 10k; pot-PT-10
SV1: ML10 ISP; con-harting-ml-ML10
SV2: ML14; con-harting-ml-ML14
SV3: ML16; con-harting-ml-ML16
X1: USB-B BU; con-berg-PN61729-S
X2: MDINBU 6/G; con-yamaichi-MDIN06S

Connections:
+3,3V: C6.1, C11.1, C12.+, IC1.20 (VCC), IC5.1 (OUT), R5.1, SV2.2
/FFS: IC2.15 ((TOSC2)PD5)
/FFS_33: SV2.8
/IRQ: IC2.12 ((INT0)PD2)
/IRQ_33: SV2.7
/RD: IC2.17 ((RD)PD7), IC4.22 (!OE)
/WE: IC2.16 ((WR)PD6), IC4.27 (!WE)
A8: IC2.21 ((A8)PC0), IC4.25 (A8)
A9: IC2.22 ((A9)PC1), IC4.24 (A9)
A10: IC2.23 ((A10)PC2), IC4.21 (A10)
A11: IC2.24 ((A11)PC3), IC4.23 (A11)
A12: IC2.25 ((A12)PC4), IC4.2 (A12)
A13: IC2.26 ((A13)PC5), IC4.26 (A13)
A14: IC2.27 ((A14)PC6), IC4.1 (A14)
A15: IC2.28 ((A15)PC7), IC4.20 (!CS)
AD0: IC2.39 ((AD0)PA0), IC3.2 (1D), IC4.11 (I/O0)
AD1: IC2.38 ((AD1)PA1), IC3.3 (2D), IC4.12 (I/O1)
AD2: IC2.37 ((AD2)PA2), IC3.4 (3D), IC4.13 (I/O2)
AD3: IC2.36 ((AD3)PA3), IC3.5 (4D), IC4.15 (I/O3)
AD4: IC2.35 ((AD4)PA4), IC3.6 (5D), IC4.16 (I/O4)
AD5: IC2.34 ((AD5)PA5), IC3.7 (6D), IC4.17 (I/O5)
AD6: IC2.33 ((AD6)PA6), IC3.8 (7D), IC4.18 (I/O6)
AD7: IC2.32 ((AD7)PA7), IC3.9 (8D), IC4.19 (I/O7)
ALE: IC2.30 ((ALE)PE1), IC3.11 (C)
D+: R3.2, X1.3
D-: R2.2, R5.2, X1.2
DGND: C1.2, C2.2, C3.2, C4.2, C5.2, C6.2, C7.2, C8.2, C9.-, C10.2, C11.2, C12.-, H1.B3,2, H2.B3,2, H3.B3,2, H4.B3,2, IC1.10 (GND), IC2.20 (GND), IC3.1 (OC), IC3.10 (GND), IC4.14 (VSS), IC5.2 (GND), R20.A, SV1.4, SV1.6, SV1.8, SV1.10, SV2.10, SV2.11, SV2.12, SV2.13, SV2.14, SV3.1, X1.4, X1.S1, X1.S2, X2.3
EN: IC2.29 ((OC1B)PE2), SV3.6
FFIT: IC2.31 ((INT2)PE0)
FFIT_33: SV2.9
KB_CLK: IC2.13 ((INT1)PD3), X2.5
KB_D: IC2.14 ((TOSC1)PD4), X2.1
LCD0: IC2.1 ((T0)PB0), SV3.11
LCD1: IC2.2 ((T1)PB1), SV3.12
LCD2: IC2.3 ((RXD1)PB2), SV3.13
LCD3: IC2.4 ((TXD1)PB3), SV3.14
MISO: IC2.7 ((MISO)PB6), SV1.9
MISO_33: SV2.6
MOSI: IC2.6 ((MOSI)PB5), SV1.1
MOSI_33: SV2.3
unnamed: C1.1, IC1.4 (XTAL2), Q1.2
unnamed: C2.1, IC1.5 (XTAL1), Q1.1
unnamed: C4.1, IC2.18 (XTAL2), Q2.2
unnamed: C5.1, IC2.19 (XTAL1), Q2.1
unnamed: IC1.2 ((RXD)PD0), R6.1
unnamed: IC1.3 ((TXD)PD1), R7.1
unnamed: IC1.6 ((INT0)PD2), R3.1
unnamed: IC1.7 ((INT1)PD3), R2.1
unnamed: IC3.12 (8Q), IC4.3 (A7)
unnamed: IC3.13 (7Q), IC4.4 (A6)
unnamed: IC3.14 (6Q), IC4.5 (A5)
unnamed: IC3.15 (5Q), IC4.6 (A4)
unnamed: IC3.16 (4Q), IC4.7 (A3)
unnamed: IC3.17 (3Q), IC4.8 (A2)
unnamed: IC3.18 (2Q), IC4.9 (A1)
unnamed: IC3.19 (1Q), IC4.10 (A0)
unnamed: L1.1, X1.1
unnamed: LED1.K (C), R4.1
unnamed: R4.2, SV1.3
unnamed: R20.S, SV3.3
RESET: IC2.9 (RESET), SV1.5
RXD/RS: IC2.10 ((RXD0)PD0), R7.2, SV3.4
SCK: IC2.8 ((SCK)PB7), SV1.7
SCK_33: SV2.4
SS: IC2.5 ((SS)PB4)
SS_33: SV2.5
TXD/RW: IC2.11 ((TXD0)PD1), R6.2, SV3.5
VCC: C3.1, C7.1, C8.1, C9.+, C10.1, IC2.40 (VCC), IC3.20 (VCC), IC4.28 (VCC), IC5.3 (IN), L1.2, LED1.A, R20.E, SV1.2, SV3.2, X2.4
