abdulmajeed90/hopemesh-thesis/pcb/level_shifter.sch

## KiCad design pcb/level_shifter.sch (2011-03-14)

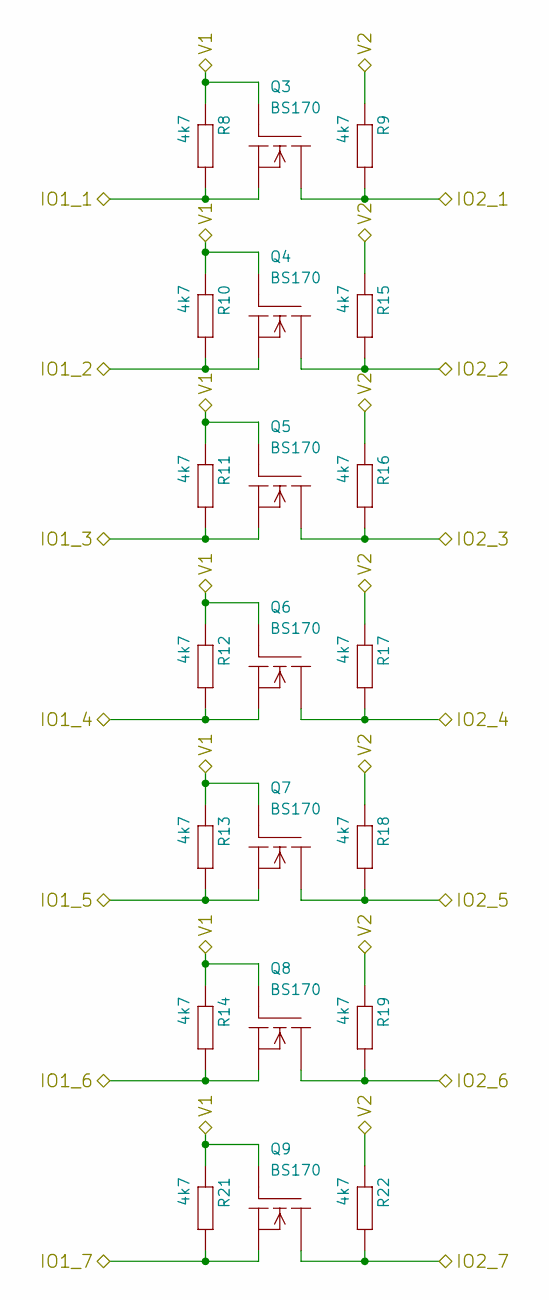
[picture p40: schematic level_shifter.sch]

Parts:
Q3, Q4, Q5, Q6, Q7, Q8, Q9: BS170
R8, R9, R10, R11, R12, R13, R14, R15, R16, R17, R18, R19, R21, R22: 4k7; rcl-0204/7

Connections:
IO1_1: Q3.1 (S), R8.2
IO1_2: Q4.1 (S), R10.2
IO1_3: Q5.1 (S), R11.2
IO1_4: Q6.1 (S), R12.2
IO1_5: Q7.1 (S), R13.2
IO1_6: Q8.1 (S), R14.2
IO1_7: Q9.1 (S), R21.2
IO2_1: Q3.3 (D), R9.2
IO2_2: Q4.3 (D), R15.2
IO2_3: Q5.3 (D), R16.2
IO2_4: Q6.3 (D), R17.2
IO2_5: Q7.3 (D), R18.2
IO2_6: Q8.3 (D), R19.2
IO2_7: Q9.3 (D), R22.2
V1: Q3.2 (G), Q4.2 (G), Q5.2 (G), Q6.2 (G), Q7.2 (G), Q8.2 (G), Q9.2 (G), R8.1, R10.1, R11.1, R12.1, R13.1, R14.1, R21.1
V2: R9.1, R15.1, R16.1, R17.1, R18.1, R19.1, R22.1
