abdulmajeed90/hopemesh-thesis/(commit log)

2011-05-02 moved thread initialization back to rfm12.c
2011-05-13 included radio state switching
2011-06-02 moved uart enabling routine to seperate thread. now the uart tx
2011-06-05 cleaned up l3 methods and reversed byte order in llc
    [l3.c, l3.h]
2011-06-08 removed unused code from spi and added more mock logic to rfm12b
2011-06-09 atomic semaphore wait, isr call mock, enhanced test
    - added atomic semaphore wait which disables all interrupts during mutex check
    - #defined ISR_CALL which gets isr variable conforming to io.h
    - enhanced test which only then calls an isr, if global interrupts are enabled
    removed ringbuffers from spi.c, addded isr declarations in test
    cleanup
    progress
2011-06-15 timer impl., 1st ogm impl., config impl., llc refactoring, rfm12b driver fixes
    - added timer
    - added first ogm implementation
    - added config implementation
    - refactored llc layer -> seperated packet and state struct
    - corrected critical rfm12b driver behaviour
    - is_fifo_ready was not executed at every isr call
    - signal loss detection fixed
    [l3.c, main.c]
2011-06-20 configurable node address in makefile, collision detection
    [l3.c]
2011-06-29 introduction of uart mutex
2011-06-29 further uart refactorings
2011-07-06 added memcpy to out in shell tx method, refactored uart
2011-07-13 optimized uart sending
2011-08-06 switched to english babel
2011-08-30 Added text to copper layer
    [hopemesh.brd]
2011-08-31 pcb silk screen enhancements
    [hopemesh.brd]
2011-09-01 packet and frame figures for the network chapter, notes on the network chapter
2011-10-14 schematics on one page including captions
